jshuffak/FramePerfect/README.md

# FramePerfect
Code for using a Freescale 9S12C32 to intercept a GameCube controller's signal and replace it with a macro.

Project demonstration video is coming soon.

Code is contained in the folder: Gamecube_Project_Triggered/Sources/

Hardware code is contained in the folder: Output Test/GAL/ 

Special thanks to team members Kyle Diekhoff, Eric Colter, and Diego De La Fuente for pulling this one off and placing 2nd place in the Purdue Spark Challenge.

See https://engineering.purdue.edu/ECESS/spark/ for more information about the bi-annual competition hosted at Purdue University.
