jshuffak/FramePerfect/Hardware/Eagle/Gamecube3.brd

## EAGLE design Hardware/Eagle/Gamecube3.brd (2016-06-11)

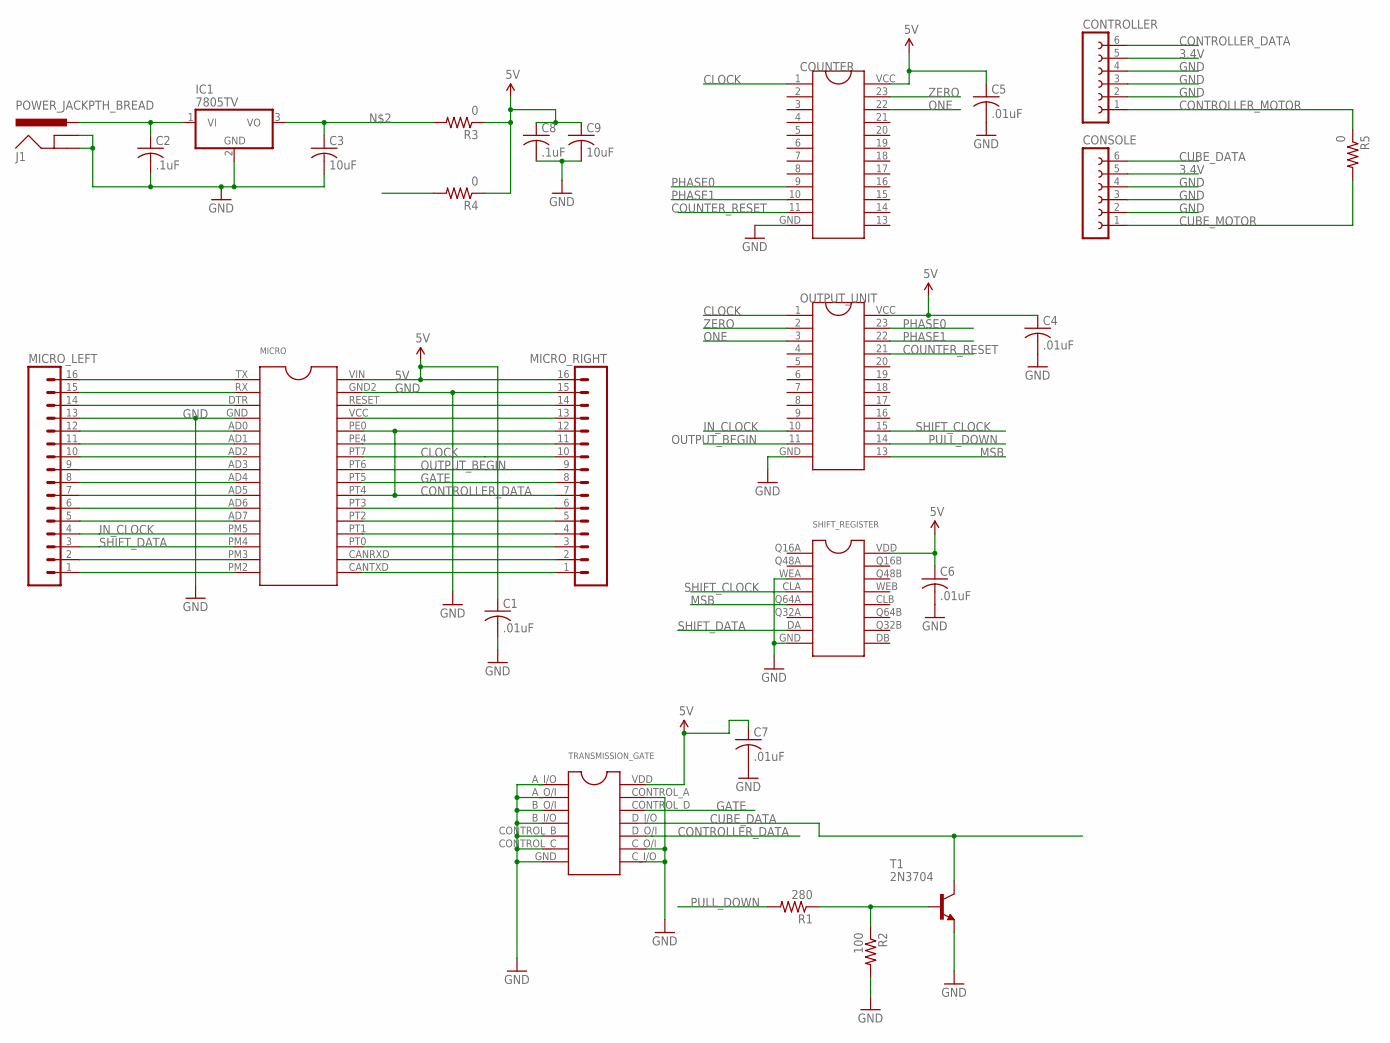
[picture p12: schematic Gamecube3.sch]

Parts:
C1, C4, C5, C6, C7: .01uF; C0805
C2, C8: .1uF; C0805
C3, C9: 10uF; C1206
CONSOLE: FE06-1; FE06
CONTROLLER: FE06-1; FE06
COUNTER: GAL22V10; 24-PIN-DIP
IC1: 7805TV; TO220V
J1: POWER_JACKPTH_BREAD; POWER_JACK_PTH_BREAD
MICRO: 9S12C32; 9S12-32PIN-DIP
MICRO_LEFT: M16; 16P
MICRO_RIGHT: M16; 16P
OUTPUT_UNIT: GAL22V10; 24-PIN-DIP
R1: 280; 0204/7
R2: 100; 0204/7
R3, R4, R5: 0; 0204/7
SHIFT_REGISTER: CD4517B
T1: 2N3704; TO92
TRANSMISSION_GATE: CD4066B

Connections:
3.4V: CONSOLE.5, CONTROLLER.5
5V: C1.1, C4.1, C5.1, C6.1, C7.1, C8.1, C9.1, COUNTER.VCC, MICRO.VIN, MICRO_RIGHT.16, OUTPUT_UNIT.VCC, R3.1, R4.1, SHIFT_REGISTER.VDD, TRANSMISSION_GATE.VDD
CLOCK: COUNTER.1, MICRO.PT7, MICRO_RIGHT.10, OUTPUT_UNIT.1
CONTROLLER_DATA: CONTROLLER.6, MICRO.PE0, MICRO.PT4, MICRO_RIGHT.7, MICRO_RIGHT.12, TRANSMISSION_GATE.D_O/I
CONTROLLER_MOTOR: CONTROLLER.1, R5.1
COUNTER_RESET: COUNTER.11, OUTPUT_UNIT.21
CUBE_DATA: CONSOLE.6, T1.2 (C), TRANSMISSION_GATE.D_I/O
CUBE_MOTOR: CONSOLE.1, R4.2, R5.2
GATE: MICRO.PT5, MICRO_RIGHT.8, TRANSMISSION_GATE.CONTROL_D
GND: C1.2, C2.2, C3.2, C4.2, C5.2, C6.2, C7.2, C8.2, C9.2, CONSOLE.2, CONSOLE.3, CONSOLE.4, CONTROLLER.2, CONTROLLER.3, CONTROLLER.4, COUNTER.GND, IC1.2 (GND), J1.GND, J1.GNDBREAK, MICRO.GND, MICRO.GND2, MICRO_LEFT.13, MICRO_RIGHT.15, OUTPUT_UNIT.GND, R2.2, SHIFT_REGISTER.GND, SHIFT_REGISTER.WEA, T1.3 (E), TRANSMISSION_GATE.A_I/O, TRANSMISSION_GATE.A_O/I, TRANSMISSION_GATE.B_I/O, TRANSMISSION_GATE.B_O/I, TRANSMISSION_GATE.CONTROL_A, TRANSMISSION_GATE.CONTROL_B, TRANSMISSION_GATE.CONTROL_C, TRANSMISSION_GATE.C_I/O, TRANSMISSION_GATE.C_O/I, TRANSMISSION_GATE.GND
IN_CLOCK: MICRO.PM5, MICRO_LEFT.4, OUTPUT_UNIT.10
MSB: OUTPUT_UNIT.13, SHIFT_REGISTER.Q64A
unnamed: C2.1, IC1.1 (VI), J1.PWR
unnamed: C3.1, IC1.3 (VO), R3.2
unnamed: R1.1, R2.1, T1.1 (B)
unnamed: MICRO.CANTXD, MICRO_RIGHT.1
unnamed: MICRO.PM2, MICRO_LEFT.1
unnamed: MICRO.PM3, MICRO_LEFT.2
unnamed: MICRO.AD7, MICRO_LEFT.5
unnamed: MICRO.AD6, MICRO_LEFT.6
unnamed: MICRO.AD5, MICRO_LEFT.7
unnamed: MICRO.AD4, MICRO_LEFT.8
unnamed: MICRO.AD3, MICRO_LEFT.9
unnamed: MICRO.AD2, MICRO_LEFT.10
unnamed: MICRO.AD1, MICRO_LEFT.11
unnamed: MICRO.AD0, MICRO_LEFT.12
unnamed: MICRO.DTR, MICRO_LEFT.14
unnamed: MICRO.RX, MICRO_LEFT.15
unnamed: MICRO.TX, MICRO_LEFT.16
unnamed: MICRO.CANRXD, MICRO_RIGHT.2
unnamed: MICRO.PT0, MICRO_RIGHT.3
unnamed: MICRO.PT1, MICRO_RIGHT.4
unnamed: MICRO.PT2, MICRO_RIGHT.5
unnamed: MICRO.PT3, MICRO_RIGHT.6
unnamed: MICRO.PE4, MICRO_RIGHT.11
unnamed: MICRO.VCC, MICRO_RIGHT.13
unnamed: MICRO.RESET, MICRO_RIGHT.14
ONE: COUNTER.22, OUTPUT_UNIT.3
OUTPUT_BEGIN: MICRO.PT6, MICRO_RIGHT.9, OUTPUT_UNIT.11
PHASE0: COUNTER.9, OUTPUT_UNIT.23
PHASE1: COUNTER.10, OUTPUT_UNIT.22
PULL_DOWN: OUTPUT_UNIT.14, R1.2
SHIFT_CLOCK: OUTPUT_UNIT.15, SHIFT_REGISTER.CLA
SHIFT_DATA: MICRO.PM4, MICRO_LEFT.3, SHIFT_REGISTER.DA
ZERO: COUNTER.23, OUTPUT_UNIT.2

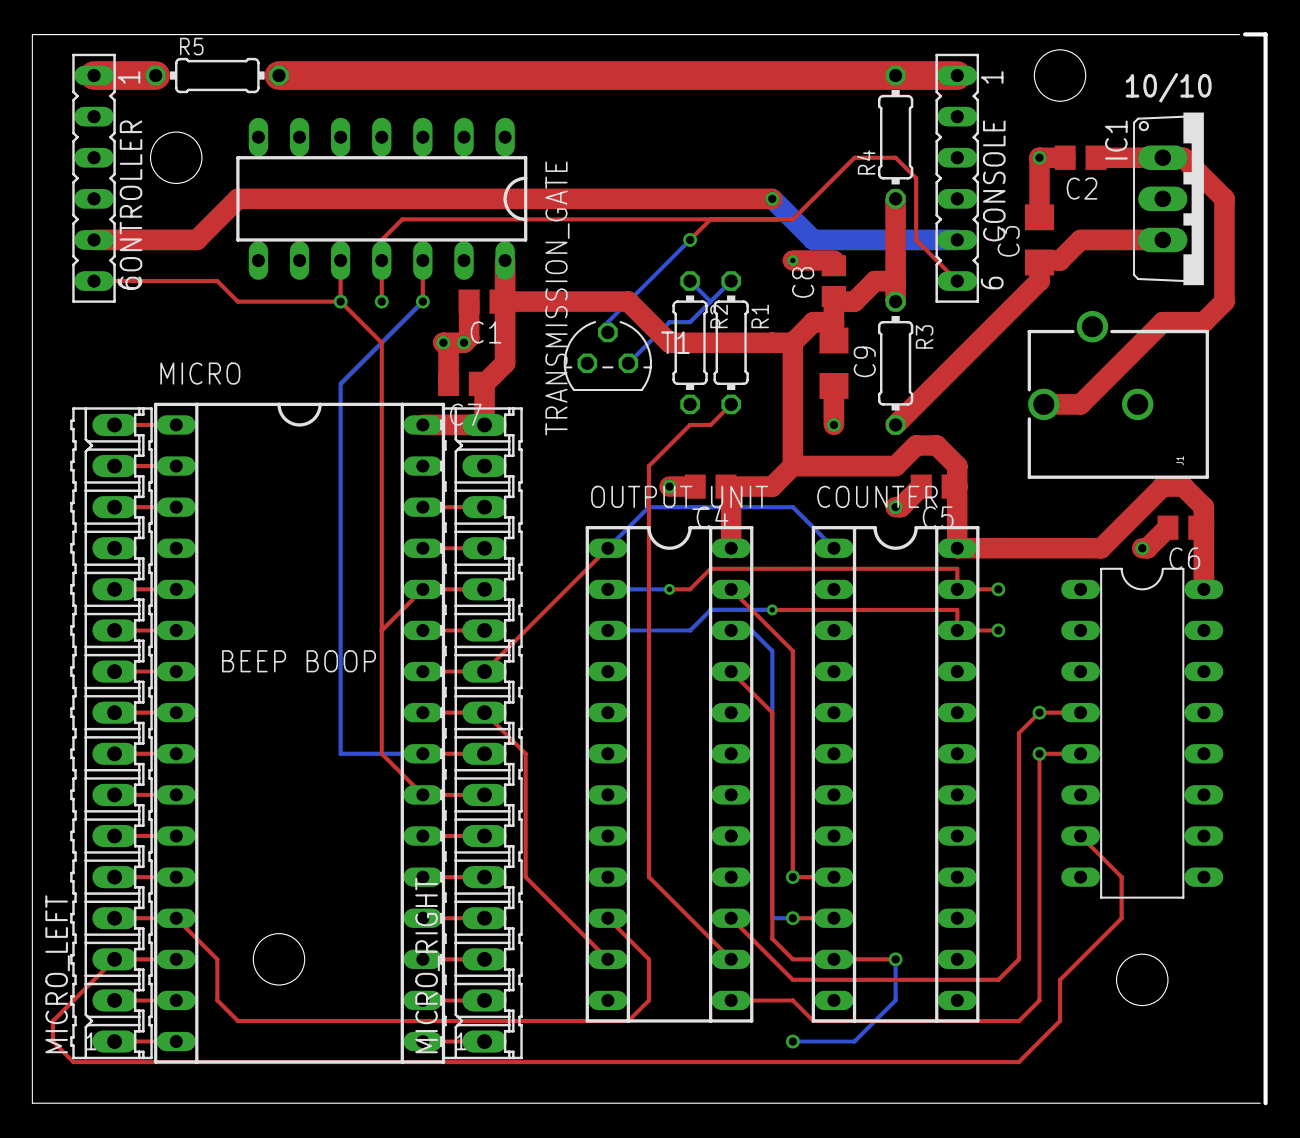
[picture p13: board Gamecube3.brd from above]

Board: 2 copper layers, 76.2 x 66.0 mm, 26 parts (0 on the bottom side), 45 nets.
