jshuffak/FramePerfect/Gamecube_Project_Triggered/Sources/macro.c

#include "macro.h"



const Input Macro_array[MAC_1 + MAC_2 + MAC_3 + MAC_4 + MAC_5 + MAC_6 + MAC_7 + MAC_8 + MAC_9 + MAC_10 + MAC_11 + MAC_12 + MAC_13 + MAC_14 + MAC_15 + MAC_16 + MAC_17 + MAC_18 + MAC_19 + MAC_20 + MAC_21 + MAC_22 + MAC_23 + MAC_24 + MAC_25 + MAC_26 + MAC_27 + MAC_28]
= {
      // Macro 1: Crap -- CHANGE ME!!  
      {0,0,0,0,0,0,1,0,0,0,0,0,0,0,0,255,0,0,0,0},
      {3,0,1,0,0,0,1,0,0,0,0,0,0,0,0,0,0,0,0,0}, 
      
      
      // Macro 2: Wave-dash Left -- NEEDS UPDATE
      {0,0,1,0,0,0,0,0,0,0,0,0,0,0,128,128,128,128,0,0},
      {0,0,0,0,0,0,0,0,0,0,0,0,0,0,128,128,128,128,0,0},
      {0,0,0,0,0,0,0,1,0,0,0,0,0,0,30,30,128,128,0,0},
      {0,0,0,0,0,0,0,0,0,0,0,0,0,0,128,128,128,128,0,0},  
      {3,0,0,0,0,0,0,0,0,0,0,0,0,0,128,128,128,128,0,0},
      
      
       // Macro 3: Short-hop Double Laser 
      {0,0,0,0,0,0,0,0,0,0,0,0,0,0,129,128,128,128,0,0},
      {0,0,0,0,0,0,0,0,0,0,0,0,0,0,129,128,128,128,0,0},
      {0,0,1,0,0,0,0,0,0,0,0,0,0,0,129,128,128,128,0,0},
      {0,0,0,0,0,0,0,0,0,0,0,0,0,0,129,128,128,128,0,0},
      {0,0,0,0,1,0,0,0,0,0,0,0,0,0,128,128,128,128,0,0},
      {0,0,0,0,0,0,0,0,0,0,0,0,0,0,129,128,128,128,0,0},
      {0,0,0,0,1,0,0,0,0,0,0,0,0,0,128,128,128,128,0,0},
      {0,0,0,0,0,0,0,0,0,0,0,0,0,0,129,128,128,128,0,0},
      {0,0,0,0,0,0,0,0,0,0,0,0,0,0,129,128,128,128,0,0},
      {0,0,0,0,0,0,0,0,0,0,0,0,0,0,129,128,128,128,0,0},
      {0,0,0,0,0,0,0,0,0,0,0,0,0,0,129,128,128,128,0,0},
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
      {0,0,0,0,0,0,1,0,0,0,0,0,0,0,0,128,128,128,0,0},
      {0,0,0,0,0,0,1,0,0,0,0,0,0,0,0,128,128,128,0,0},
      {0,0,0,0,0,0,1,0,0,0,0,0,0,0,0,128,128,128,0,0},
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
       
  }; 
     


int GetMacroInput(MacroFrame frame, Input* output, Input* input)
{


  output->Garbage = 0;
  output->Start = Macro_array[(int)frame.Frame/2 + frame.Macro].Start;
  output->Y = Macro_array[(int)frame.Frame/2 + frame.Macro].Y;
  output->X = Macro_array[(int)frame.Frame/2 + frame.Macro].X;
  output->B = Macro_array[(int)frame.Frame/2 + frame.Macro].B;
  output->A = Macro_array[(int)frame.Frame/2 + frame.Macro].A;
  output->Garbage1 = 1;
  output->L = Macro_array[(int)frame.Frame/2 + frame.Macro].L;
  output->R = Macro_array[(int)frame.Frame/2 + frame.Macro].R;
  output->Z = Macro_array[(int)frame.Frame/2 + frame.Macro].Z;
  output->DUp = Macro_array[(int)frame.Frame/2 + frame.Macro].DUp;
  output->DDown = Macro_array[(int)frame.Frame/2 + frame.Macro].DDown;
  output->DRight = Macro_array[(int)frame.Frame/2 + frame.Macro].DRight;
  output->DLeft = Macro_array[(int)frame.Frame/2 + frame.Macro].DLeft;
  if (Macro_array[(int)frame.Frame/2 + frame.Macro].JoyX == 129)
    output->JoyX = input->JoyX;
  else
    output->JoyX = Macro_array[(int)frame.Frame/2 + frame.Macro].JoyX;
  if (Macro_array[(int)frame.Frame/2 + frame.Macro].JoyY == 129)
    output->JoyY = input->JoyY;
  else
    output->JoyY = Macro_array[(int)frame.Frame/2 + frame.Macro].JoyY;
  output->CStickX = Macro_array[(int)frame.Frame/2 + frame.Macro].CStickX;
  output->CStickY = Macro_array[(int)frame.Frame/2 + frame.Macro].CStickY;
  output->LeftButt = Macro_array[(int)frame.Frame/2 + frame.Macro].LeftButt;
  output->RightButt = Macro_array[(int)frame.Frame/2 + frame.Macro].RightButt;
  if((Macro_array[(int)frame.Frame/2 + frame.Macro].Garbage == 3 && (frame.Frame % 2 == 1)))
  {
    
    return 1;
    
  }

  return 0;
}
