jshuffak/FramePerfect/Gamecube_Project_Triggered/Sources/scheme.c

#include "scheme.h"

Scheme Scheme1 = { MACRO10, MACRO3, MACRO9, MACRO4, MACRO4, MACRO7, MACRO8 };
Scheme Scheme2 = { MACRO11, MACRO2, MACRO6, MACRO2, MACRO2, MACRO2, MACRO2 };
Scheme Scheme3 = { MACRO10, MACRO3, MACRO9, MACRO4, MACRO4, MACRO7, MACRO8 };
Scheme Scheme4 = { MACRO10, MACRO3, MACRO9, MACRO4, MACRO4, MACRO7, MACRO8 };
