jshuffak/FramePerfect/(commit log)

2015-11-21 Added some sample structure files to the repo.
2015-12-05 Change define
    Rickster the fan man
2015-12-05 Update macro.h
    Fixed macro.h
    [macro.h]
2015-12-05 Added scheme.c to the codewarrior project and fixed a bug to let it compile.
    [control.c, main.c, scheme.c]
2015-12-05 Added Kyle's Macro generator into the repo.
    [Macro generation excel.xlsm]
2015-12-07 Fixed a bug in the macro.c file.
    [macro.c]
2015-12-07 Changed the routine to mask the left and right slider values when the macro button is pressed.
2015-12-07 Now masks the x and y joystick values when the macro button is pressed unless they cross the x and y thresholds.
2015-12-07 Changed the thresholds to be a snappier value.
    [control.c]
2015-12-07 Added a watchdog timer to the micro to ensure that the protocol is working properly.
2015-12-07 Refixed a debugging problem and added an initial state of input.
    [main.c, microcontroller.c]
2015-12-07 Updated initial bits sent to GAL
    Updated the initial bits to be blank inputs so that the GAL doesn't output garbage initially.
    [microcontroller.c]
2015-12-08 Assert macro frames 2 times
    Changed the macro so that each frame is asserted 2 times instead of 3.
2015-12-08 Updated a couple of macros
    Updated some macros with the new 2 input frame per game frame protocol.
2015-12-09 Added drillshine. Test1
2015-12-09 added drillshine to scheme1 x-z
2015-12-09 updated drillshine macro8
2015-12-09 update macro.h for drill
2015-12-09 DRILL 2
2015-12-09 DRILL 3
2015-12-09 Commiting broken DrillShine
    Broken drill shine
    [macro.c]
2015-12-11 Pinout changed to work on PCB
2016-06-11 Added Eagle files
    [Gamecube3.brd, Gamecube3.sch]
